melisa089/EKG_On_Yukseltec_PCB/(list of files, drawings)

Other design files:
EKG_PCB_Tasarım.pdsprj
EKG_simülasyon.pdsprj
